ajelec20ajy/Embedded-System-Experiment/ONLY_MAIN/README.md

Zone1~Zone4 Folder : 각 Zone 콘트롤러 및 하위 액추에이터/센서

main.c : 중앙 제어기 코드(라즈베리파이 제로 2W : RaspberryPi OS-64bit, SocketCAN 사용)
