ajelec20ajy/Embedded-System-Experiment/ALL_FILE/Zone1/Zone1_LOCAL/Zone1_LOCAL.ioc

Mcu.UserName=STM32F103C8Tx
PA10.Signal=USART1_RX
PA11.Signal=CAN_RX
PA12.Signal=CAN_TX
PA3.GPIO_Label=DRDY_SONIC
PA3.Signal=GPXTI3
PA4.GPIO_Label=CS_SONIC
PA4.Signal=GPIO_Output
PA5.Signal=SPI1_SCK
PA6.Signal=SPI1_MISO
PA7.Signal=SPI1_MOSI
PA8.GPIO_Label=DRDY_PEDAL
PA8.Signal=GPXTI8
PA9.Signal=USART1_TX
PB12.GPIO_Label=CS_PEDAL
PB12.Signal=GPIO_Output
PB13.Signal=SPI2_SCK
PB14.Signal=SPI2_MISO
PB15.Signal=SPI2_MOSI
PC13-TAMPER-RTC.GPIO_Label=LED
PC13-TAMPER-RTC.Signal=GPIO_Output
