ajelec20ajy/Embedded-System-Experiment/ALL_FILE/Zone1/Zone1_LOCAL/Core/Src/main.c

#include "main.h"
#include "cmsis_os.h"

#include "stdbool.h"
#include <stdio.h>
#include <string.h>
CAN_HandleTypeDef hcan;

SPI_HandleTypeDef hspi1;
SPI_HandleTypeDef hspi2;
DMA_HandleTypeDef hdma_spi1_rx;
DMA_HandleTypeDef hdma_spi1_tx;
DMA_HandleTypeDef hdma_spi2_rx;
DMA_HandleTypeDef hdma_spi2_tx;

UART_HandleTypeDef huart1;

/* Definitions for CAN */
osThreadId_t CANHandle;
const osThreadAttr_t CAN_attributes = {
  .name = "CAN",
  .stack_size = 256 * 4,
  .priority = (osPriority_t) osPriorityHigh,
};
/* Definitions for SPI1 */
osThreadId_t SPI1Handle;
const osThreadAttr_t SPI1_attributes = {
  .name = "SPI1",
  .stack_size = 128 * 4,
  .priority = (osPriority_t) osPriorityHigh,
};
/* Definitions for SPI2 */
osThreadId_t SPI2Handle;
const osThreadAttr_t SPI2_attributes = {
  .name = "SPI2",
  .stack_size = 128 * 4,
  .priority = (osPriority_t) osPriorityHigh,
};
/* Definitions for cansonicQueue */
osMessageQueueId_t cansonicQueueHandle;
const osMessageQueueAttr_t cansonicQueue_attributes = {
  .name = "cansonicQueue"
};
/* Definitions for canpedalQueue */
osMessageQueueId_t canpedalQueueHandle;
const osMessageQueueAttr_t canpedalQueue_attributes = {
  .name = "canpedalQueue"
};

void SystemClock_Config(void);
static void MX_GPIO_Init(void);
static void MX_DMA_Init(void);
static void MX_SPI1_Init(void);
static void MX_SPI2_Init(void);
static void MX_USART1_UART_Init(void);
static void MX_CAN_Init(void);
void canTask(void *argument);
void spi1Task(void *argument);
void spi2Task(void *argument);

#include <stdint.h>
#include <string.h>
#include <stdio.h>
#include "stdlib.h" // atoi
#include "string.h" // memcpy

#define FLAG_SONIC_READ            0x0001
#define FLAG_PEDAL_READ            0x0002
#define FLAG_SONIC_DMA_COMPLETE    0x0004
#define FLAG_PEDAL_DMA_COMPLETE    0x0008


#pragma pack(push,1)
typedef struct{
	uint8_t header;
	int16_t data;
	uint8_t status;
	uint8_t seq;
	uint8_t reserved;
	uint8_t crc;
	uint8_t tail;
}SPI_Packet_t;
#pragma pack(pop)

typedef union{
	SPI_Packet_t pkt;
	uint8_t bytes[8];
}SPI_Buffer_t;

int16_t g_distance;
int16_t g_accel, g_brake, g_pedal;

// SPI용 버퍼. VOLATILE! 매번 체크
volatile SPI_Buffer_t pedal_rx;
volatile SPI_Buffer_t pedal_tx;
volatile SPI_Buffer_t sonic_rx;
volatile SPI_Buffer_t sonic_tx;

volatile uint8_t SPI1_ERR_FLAG = 0; //SPI1의 에러를 알려줄 플래그
volatile uint8_t SPI2_ERR_FLAG = 0; //SPI2의 에러를 알려줄 플래그


static uint8_t crc_xor(const uint8_t *p, int n) { // CRC 계산해주는 함수
  uint8_t c = 0;
  for (int i = 0; i < n; i++) c ^= p[i];
  return c;
}

void HAL_SPI_TxRxCpltCallback(SPI_HandleTypeDef *hspi) {
	if (hspi->Instance == SPI1) {
		osThreadFlagsSet(SPI1Handle, FLAG_SONIC_DMA_COMPLETE);
	}
	else if (hspi->Instance == SPI2) {
		osThreadFlagsSet(SPI2Handle, FLAG_PEDAL_DMA_COMPLETE);
	}
}

void HAL_SPI_ErrorCallback(SPI_HandleTypeDef *hspi) {
	if (hspi->Instance == SPI1) {
		osThreadFlagsSet(SPI1Handle, FLAG_SONIC_DMA_COMPLETE);
		HAL_SPI_DMAStop(hspi); // 그냥 껏다 키기
		hspi->State = HAL_SPI_STATE_READY; // 강제로 통신 가능 상태로 복구
	}
	else if (hspi->Instance == SPI2) {
		osThreadFlagsSet(SPI2Handle, FLAG_PEDAL_DMA_COMPLETE);
		HAL_GPIO_TogglePin(LED_GPIO_Port, LED_Pin);
		HAL_SPI_DMAStop(hspi);
		hspi->State = HAL_SPI_STATE_READY; // 강제로 통신 가능 상태로 복구
	}
}

void HAL_GPIO_EXTI_Callback(uint16_t GPIO_Pin) {
	switch(GPIO_Pin){
	case DRDY_SONIC_Pin:
		osThreadFlagsSet(SPI1Handle, FLAG_SONIC_READ);
		break;
	case DRDY_PEDAL_Pin:

		osThreadFlagsSet(SPI2Handle, FLAG_PEDAL_READ);
		break;
	default:
		break;
	}
}
// CAN
#define OFF 0x01
#define READY 0x02
#define DRIVE 0x04
#define EMERGENCY 0x08
#define MOTOR_ERR 0x10
#define PEDAL_ERR 0x20
#define CENTRAL_DOWN 0x40
#define BROKEN_SELF 0x80

#define ID_1_SONIC 0x010
#define ID_1_PEDAL 0x040
#define ID_1_HB 0x071
#define ID_1_PEDAL_SPI_ERR 0x022

#define ID_2_SONIC 0x011
#define ID_2_MOTOR_STATUS 0x110
#define ID_2_MOTOR_SPI_ERR 0x020
#define ID_2_HB 0x072

#define ID_3_ACC 0x012
#define ID_3_HB 0x073

#define ID_4_IR 0x142
#define ID_4_BTN 0x144
#define ID_4_HB 0x074

#define ID_CENTRAL_MOTOR_ERR 0x001
#define ID_CENTRAL_EMERGENCY 0x002
#define ID_CENTRAL_STATUS 0x004 // = HEARBEAT ID OF CENTRAL
#define ID_HARDWARE_ERR 0x7FF


// RTOS용 FLAG
#define FLAG_STATE_OFF			0x11
#define FLAG_STATE_READY		0x22
#define FLAG_STATE_DRIVE		0x44
#define FLAG_STATE_EMERGENCY	0x88
#define FLAG_STATE_MOTOR_ERR	0xAA

typedef enum { // 에러 종류
    ERR_TYPE_RX_STUCK,    // 데이터 갱신 안됨
    ERR_TYPE_TX_FAIL,     // 내 CAN의 하드웨어 에러
    ERR_TYPE_HW,          // 내 CAN의 하드웨어 에러
    ERR_TYPE_CHKSUM       // 데이터 변조 감지
} CAN_Err_Type;

typedef union {
    struct {
        uint16_t data;
	uint8_t reserved[4];
	uint8_t counter;
	uint8_t checksum;
    } __attribute__((packed)) data16;
    struct {
        uint16_t data1;
        uint16_t data2;
        uint8_t reserved[2];
	uint8_t counter;
	uint8_t checksum;
    } __attribute__((packed)) data32;
    uint8_t bytes[8];
} CAN_Payload_t; // CAN 데이터 패킷

typedef struct{
	uint8_t z1;
	uint8_t z2;
	uint8_t z3;
	uint8_t z4;
	uint8_t central;
} CAN_CNT; // 다용도 카운터 구조체

CAN_CNT stuck_counter; // 중앙제어기 RX 걸렸는지
CAN_CNT last_counter; // 패킷의 시퀀스 검증용
CAN_CNT can_rx_err_cnt; // 에러 카운트용
uint32_t last_zone_rx_time; // 중앙 제어기 다운 타임아웃 감지용
volatile uint8_t state_global = OFF; // 시스템 상태
uint8_t global_tx_counter = 0; // 패킷에 담을 시퀀스를 위함

void Put_Latest_Data(osMessageQueueId_t queueHandle, int16_t data){ // Size 1 Queue Overwrite하기
	int16_t msg = data;
	    if(osMessageQueueGetCount(queueHandle) > 0){
	        int16_t dummy;
	        osMessageQueueGet(queueHandle, &dummy, NULL, 0);
	    }
	    osMessageQueuePut(queueHandle, &msg, 0, 0);
}
void CAN_OFF_FILTER(){ // 필터 끄기
	CAN_FilterTypeDef canFilter;
				canFilter.FilterBank = 0;
				canFilter.FilterMode = CAN_FILTERMODE_IDLIST;
				canFilter.FilterScale = CAN_FILTERSCALE_16BIT;
				canFilter.FilterIdHigh = (0x001 << 5);
				canFilter.FilterIdLow = (0x002 << 5);
				canFilter.FilterMaskIdHigh = (0x004 << 5);
				canFilter.FilterMaskIdLow = (0x000 << 5);
				canFilter.FilterFIFOAssignment = CAN_RX_FIFO0;
				canFilter.FilterActivation = DISABLE;
				canFilter.SlaveStartFilterBank = 14;
				HAL_CAN_ConfigFilter(&hcan, &canFilter);
}
void CAN_ERR_HANDLE(uint32_t ID, CAN_Err_Type type){ // CAN 에러 핸들러
	switch(ID){
	case ID_1_SONIC:
	case ID_1_PEDAL:
	case ID_1_HB:
		can_rx_err_cnt.z1++;
		if(can_rx_err_cnt.z1>=20){
			HAL_CAN_Stop(&hcan);
			state_global = BROKEN_SELF;
		}
		break;
	case ID_CENTRAL_STATUS:
		can_rx_err_cnt.central++;
		if(can_rx_err_cnt.central>=20){
			CAN_OFF_FILTER();
			state_global = CENTRAL_DOWN;
		}
		break;

	case ID_HARDWARE_ERR: // 하드웨어 에러는 바로 처리
		if(type == ERR_TYPE_HW){
			state_global = BROKEN_SELF;
		}
		break;

	default:
		break;
	}
}

void HAL_CAN_RxFifo0MsgPendingCallback(CAN_HandleTypeDef *hcan){ // 캔 RX 콜백
	CAN_RxHeaderTypeDef rxHeader;
	CAN_Payload_t payload = { 0 };
    if(HAL_CAN_GetRxMessage(hcan, CAN_RX_FIFO0, &rxHeader, payload.bytes) == HAL_OK){
    	if(rxHeader.IDE == CAN_ID_STD){
    			uint8_t received_sum = 0;
    			for (int i = 0; i < 7; i++) { // Checksum
    				received_sum += payload.bytes[i];
    			}
    			if (received_sum != payload.bytes[7]) {
    				CAN_ERR_HANDLE(rxHeader.StdId, ERR_TYPE_CHKSUM);
    				return; // 이번거 데이터 오염되었다 판단, 그냥 건너뜀
    			}
    			switch (rxHeader.StdId) {
    			case ID_CENTRAL_MOTOR_ERR:
    				if (payload.data16.counter == last_counter.central) {
    					if (++stuck_counter.central > 5) {
    						CAN_ERR_HANDLE(rxHeader.StdId, ERR_TYPE_RX_STUCK);
    						return; // 처리 후 return
    					}
    				}
    				else {
    					stuck_counter.central = 0;
    					last_counter.central = payload.data16.counter;
    				}

    				state_global = MOTOR_ERR;
    				last_zone_rx_time = HAL_GetTick(); // 중앙제어기 HeartBeat 감지용
    				break;
    			case ID_CENTRAL_EMERGENCY:
    				if (payload.data16.counter == last_counter.central) {
    					if (++stuck_counter.central > 5) {
    						CAN_ERR_HANDLE(rxHeader.StdId, ERR_TYPE_RX_STUCK);
    						return; // 처리 후 return
    					}
    				}
    				else {
    					stuck_counter.central = 0;
    					last_counter.central = payload.data16.counter;
    				}

    				state_global = EMERGENCY;
    				last_zone_rx_time = HAL_GetTick(); // 중앙제어기 HeartBeat 감지용
    				break;
    			case ID_CENTRAL_STATUS:
    				if (payload.data16.counter == last_counter.central) {
    					if (++stuck_counter.central > 5) {
    						CAN_ERR_HANDLE(rxHeader.StdId, ERR_TYPE_RX_STUCK);
    						return; // 처리 후 return
    					}
    				}
    				else {
    					stuck_counter.central = 0;
    					last_counter.central = payload.data16.counter;
    				}

    				if (rxHeader.DLC == 8) {
    					state_global = payload.data16.data;
    				}
    				can_rx_err_cnt.central = 0;
    				last_zone_rx_time = HAL_GetTick(); // 중앙제어기 HeartBeat 감지용
    				break;
    			}
    	}
    }
}

void CAN_INIT() { // CAN 초기화
	// 필터처리
	CAN_FilterTypeDef canFilter;
	canFilter.FilterBank = 0;
	canFilter.FilterMode = CAN_FILTERMODE_IDLIST;
	canFilter.FilterScale = CAN_FILTERSCALE_16BIT;
	canFilter.FilterIdHigh = (0x001 << 5);
	canFilter.FilterIdLow = (0x002 << 5);
	canFilter.FilterMaskIdHigh = (0x004 << 5);
	canFilter.FilterMaskIdLow = (0x000 << 5);
	canFilter.FilterFIFOAssignment = CAN_RX_FIFO0;
	canFilter.FilterActivation = ENABLE;
	canFilter.SlaveStartFilterBank = 14;

	if (HAL_CAN_ConfigFilter(&hcan, &canFilter) != HAL_OK) {
		Error_Handler();
	}

	canFilter.FilterBank = 1;
	canFilter.FilterIdHigh = (0x001 << 5);
	canFilter.FilterIdLow = (0x000 << 5);
	canFilter.FilterMaskIdHigh = (0x000 << 5);
	canFilter.FilterMaskIdLow = (0x000 << 5);

	if (HAL_CAN_ConfigFilter(&hcan, &canFilter) != HAL_OK) {
		Error_Handler();
	}

	//시작
	last_zone_rx_time = HAL_GetTick();
	HAL_CAN_Start(&hcan);
	HAL_CAN_ActivateNotification(&hcan, CAN_IT_RX_FIFO0_MSG_PENDING);
}

void CAN_SEND(uint32_t ID) { // CAN 송신 함수
	    CAN_TxHeaderTypeDef txHeader ={0};
	    uint32_t txMailbox;
	    CAN_Payload_t payload ={0};

	    txHeader.IDE = CAN_ID_STD;
	    txHeader.RTR = CAN_RTR_DATA;
	    txHeader.TransmitGlobalTime = DISABLE;
	    txHeader.StdId = ID;
	    txHeader.DLC = 8;

	    payload.data16.counter = global_tx_counter++; // 카운터(시퀀스 번호) 삽입
	    switch(ID){
		case ID_1_SONIC:
			payload.data16.data = g_distance;

			break;
		case ID_1_PEDAL:
			if(state_global == DRIVE || state_global == CENTRAL_DOWN) payload.data16.data = g_pedal;
			else payload.data16.data = 0; // emergency일때 여기서 걸린다.

			break;
		case ID_1_HB: // heartbeat
			payload.data16.data = state_global;
			//payload.data16.counter = 0; // 의도적으로 (4) EMEGENCY2 일으키기
			break;
		case ID_1_PEDAL_SPI_ERR: // 이 ID가 중앙에게 가면 중앙이 PEDAL_ERR 상태를 다른 Zone에 전파해줌
			payload.data16.data = 0; //
		default:
			break;
	    }


	    uint8_t sum = 0;
	        for (int i = 0; i < 7; i++) {
	        	sum += payload.bytes[i];
	        }
	        payload.data16.checksum = sum;

	    uint32_t tick = HAL_GetTick();
	    while (HAL_CAN_GetTxMailboxesFreeLevel(&hcan) == 0) {
	    	if (HAL_GetTick() - tick > 10) {
	    		CAN_ERR_HANDLE(ID, ERR_TYPE_TX_FAIL); // 메일박스 고임 타임아웃처리
	    		return; // 타임아웃 시 포기
	    	}
	    }

	    if (HAL_CAN_AddTxMessage(&hcan, &txHeader, payload.bytes, &txMailbox) != HAL_OK) {
	    	CAN_ERR_HANDLE(ID, ERR_TYPE_HW); // 창구에서 거절
	    }
}

void HAL_CAN_ErrorCallback(CAN_HandleTypeDef *hcan) {
	      uint32_t err = HAL_CAN_GetError(hcan); // 먼 에러인지 검사
	      uint8_t any = 0;
	      if(err & HAL_CAN_ERROR_BOF){ // BOF
	    	  any = 1;
	    	  CAN_ERR_HANDLE(ID_HARDWARE_ERR, ERR_TYPE_HW);
	      }
	      if(err & HAL_CAN_ERROR_ACK){ // ACK 없을때
	    	  any = 1;
	    	  can_rx_err_cnt.central++; // 중앙이 문제니 ACK가 없을듯
	      }

	      if(err & HAL_CAN_ERROR_RX_FOV0){ // fifo 꽉 찬 경우에
	    	  any = 1;
	    	  CAN_RxHeaderTypeDef rxHeader;
	    	  uint8_t dummyData[8];
	    	  uint32_t fillLevel = HAL_CAN_GetRxFifoFillLevel(hcan, CAN_RX_FIFO0); // 찼는지 검사
	    	  while (fillLevel > 0) {
	    	  HAL_CAN_GetRxMessage(hcan, CAN_RX_FIFO0, &rxHeader, dummyData); // 메시지를 더미로 읽어 fifo 비우기
	    	  fillLevel--;
	    	  }
	      }
	      if(!any){ // 위의 경우들은 아닌경우, 포괄에러처리
	    	  CAN_ERR_HANDLE(ID_HARDWARE_ERR, ERR_TYPE_HW);
	      }
}

int main(void)
{
  HAL_Init();

  SystemClock_Config();

  MX_GPIO_Init();
  MX_DMA_Init();
  MX_SPI1_Init();
  MX_SPI2_Init();
  MX_USART1_UART_Init();
  MX_CAN_Init();

  HAL_GPIO_WritePin(CS_SONIC_GPIO_Port, CS_SONIC_Pin, GPIO_PIN_SET);
  HAL_GPIO_WritePin(CS_PEDAL_GPIO_Port, CS_PEDAL_Pin, GPIO_PIN_SET);
  CAN_INIT();

  osKernelInitialize();

  cansonicQueueHandle = osMessageQueueNew (1, sizeof(uint16_t), &cansonicQueue_attributes);
  canpedalQueueHandle = osMessageQueueNew (1, sizeof(uint16_t), &canpedalQueue_attributes);

  CANHandle = osThreadNew(canTask, NULL, &CAN_attributes);
  SPI1Handle = osThreadNew(spi1Task, NULL, &SPI1_attributes);
  SPI2Handle = osThreadNew(spi2Task, NULL, &SPI2_attributes);

  osKernelStart();

  while (1)
  {
  }
}

void canTask(void *argument)
{
		uint16_t rx_msg;
	  uint32_t tick = osKernelGetTickCount();
	  const uint32_t kPeriod = 10U; // 10ms 주기 (100Hz)
	  uint8_t state_local = OFF;
	  bool can_stop_flag = false;

  for(;;)
  {
	  tick += kPeriod;
	  state_local = state_global;
	  if ((state_local != OFF) && (state_local != CENTRAL_DOWN) && (state_local != BROKEN_SELF))
	        {
	            if (HAL_GetTick() - last_zone_rx_time > 200) {
	          	  state_local = CENTRAL_DOWN;
	            }
	  }
	  if(SPI2_ERR_FLAG){
		  CAN_SEND(ID_1_PEDAL_SPI_ERR);
	  }
	  switch(state_local){
	        case DRIVE:
                if (osMessageQueueGet(canpedalQueueHandle, &rx_msg, NULL, 0) == osOK) {
                	if(!SPI2_ERR_FLAG) CAN_SEND(ID_1_PEDAL);
                }

                // 초음파 데이터 전송 (Queue에 데이터가 있을 때만)
                if (osMessageQueueGet(cansonicQueueHandle, &rx_msg, NULL, 0) == osOK) {
                    CAN_SEND(ID_1_SONIC);
                }
                CAN_SEND(ID_1_HB);
                break;
	        case EMERGENCY:
	        	CAN_SEND(ID_1_PEDAL); // CAN_SEND 내부에서 state == EMERGENCY일때 강제로 0을 보낸다
	        case READY:
	        case MOTOR_ERR: // 모터 정지시에는 하트비트만 보낸다
	        	CAN_SEND(ID_1_HB);
	        	break;
	        case OFF:
	        	break;
	        case CENTRAL_DOWN: // 중앙이 망가졌어도 페달 조작은 해서 사용자가 모터를 멈추는 등 운행 가능하게
	        	CAN_OFF_FILTER();
                if (osMessageQueueGet(canpedalQueueHandle, &rx_msg, NULL, 0) == osOK) {
                	if(!SPI2_ERR_FLAG) CAN_SEND(ID_1_PEDAL);
                }
	        	break;
	        case BROKEN_SELF: // 내 CAN이 망가졌으면 아예 CAN 멈춤
	        	if(can_stop_flag == false)
	        	HAL_CAN_Stop(&hcan);
	        	can_stop_flag = true;
	        	break;
	        case PEDAL_ERR: // 페달 에러시에는 하트비트와 초음파값만
                if (osMessageQueueGet(cansonicQueueHandle, &rx_msg, NULL, 0) == osOK) {
                    CAN_SEND(ID_1_SONIC);
                }
                CAN_SEND(ID_1_HB);
                break;
	  }
	  osDelayUntil(tick); // 100Hz
  }
}

void spi1Task(void *argument)
{
	/* USER CODE BEGIN 5 */
	  uint8_t SPI1_ERR_CNT = 0;
	  uint8_t last_rx_seq = 0xFF;
	  uint8_t seq = 0; // [수정 1] 시퀀스 변수 추가

	  for(;;)
	  {
	    // [1] DRDY 신호 대기 (초음파 센서가 "나 데이터 준비됐어" 할 때까지)
	    uint32_t result = osThreadFlagsWait(FLAG_SONIC_READ, osFlagsWaitAny, 150);

	    // [2] 초음파 값 받기
	    if (result & FLAG_SONIC_READ) {
	     	memset(&sonic_tx, 0, sizeof(sonic_tx));
	    	bool frame_valid = true;

	    	HAL_GPIO_WritePin(CS_SONIC_GPIO_Port, CS_SONIC_Pin, GPIO_PIN_RESET); // 슬레이브에게 통신 시작 알림
	    	if(HAL_SPI_TransmitReceive_DMA(&hspi1, (uint8_t*)&sonic_tx, (uint8_t*)&sonic_rx, 8) == HAL_OK){ // 요청
	    		// 타임아웃 20ms
	    		uint32_t sonic_res = osThreadFlagsWait(FLAG_SONIC_DMA_COMPLETE, osFlagsWaitAny, 20); // SPI DMA 완료 콜백에서 플래그 보내주길 기다리며 블락

	    		if(sonic_res == osFlagsErrorTimeout){ // DMA 타임아웃
	    			HAL_SPI_DMAStop(&hspi1); // 멈춤, 복구시도
	    			hspi1.State = HAL_SPI_STATE_READY; // READY로 강제 변경해서 복구시도(위험한 방법이라고 배움)
	    			frame_valid = false;
	    		}
	    	}
	    	else{
	    		frame_valid = false;
	    	}
	    	HAL_GPIO_WritePin(CS_SONIC_GPIO_Port, CS_SONIC_Pin, GPIO_PIN_SET); //통신 완료 처리

	    	// 데이터 검증 - 헤더, 테일, CRC
	    	if(frame_valid){
	        	if(sonic_rx.pkt.header != 0xAA) frame_valid = false;
	        	if(sonic_rx.pkt.tail != 0xED) frame_valid = false;
	        	if(crc_xor((uint8_t *)&sonic_rx.pkt, 6) != sonic_rx.pkt.crc) frame_valid = false;
	    	}

	        bool skip_update = false;

	    	if(!frame_valid){
	    		if(++SPI1_ERR_CNT >= 5){

	    			SPI1_ERR_FLAG = 1;
	    		}
	    		skip_update = true; // 이번 턴은 업데이트 건너뜀
	    	}
	        else if (sonic_rx.pkt.seq == last_rx_seq) {
	    	    if (++SPI1_ERR_CNT >= 5)
	    	        SPI1_ERR_FLAG = 1;
	    	    skip_update = true; // 중복 데이터니 업데이트 건너뜀
	    	}
	        else {
	            // 정상 데이터 수신
	        	last_rx_seq = sonic_rx.pkt.seq;
	        	SPI1_ERR_CNT = 0;
	        	SPI1_ERR_FLAG = 0;
	            skip_update = false;
	        }

	        // 유효할 때만 값 업데이트 및 큐 전송
	        if(!skip_update) {
	        	g_distance = sonic_rx.pkt.data; // 값 업데이트
	        	Put_Latest_Data(cansonicQueueHandle, g_distance); // 큐로 보냄
	        }
	    }
	  }

}


void spi2Task(void *argument)
{
	  uint8_t last_rx_seq = 0xFF;
	  uint8_t SPI2_ERR_CNT = 0;

	  for(;;)
	  {
	      // 페달 DRDY 인터럽트 대기
	      uint32_t result = osThreadFlagsWait(FLAG_PEDAL_READ, osFlagsWaitAny, osWaitForever);

	      if (result & FLAG_PEDAL_READ) {
	    	  memset(&pedal_tx, 0, sizeof(pedal_tx));
	          bool frame_valid = true;

	          // SPI 통신 수행
	          HAL_GPIO_WritePin(CS_PEDAL_GPIO_Port, CS_PEDAL_Pin, GPIO_PIN_RESET); // 슬레이브에게 통신 시작 알림
	          if(HAL_SPI_TransmitReceive_DMA(&hspi2, (uint8_t*)&pedal_tx, (uint8_t*)&pedal_rx, 8) == HAL_OK){
	              uint32_t pedal_res = osThreadFlagsWait(FLAG_PEDAL_DMA_COMPLETE, osFlagsWaitAny, 20);
	              if(pedal_res == osFlagsErrorTimeout){
	                  HAL_SPI_DMAStop(&hspi2);
	                  hspi2.State = HAL_SPI_STATE_READY;
	                  frame_valid = false;
	              }
	          }
	          else { frame_valid = false; }

	          HAL_GPIO_WritePin(CS_PEDAL_GPIO_Port, CS_PEDAL_Pin, GPIO_PIN_SET); //통신 완료 처리

	          // 데이터 검증- 헤더, 테일, CRC
	          if(frame_valid){
	              if(pedal_rx.pkt.header != 0xAA) frame_valid = false;
	              if(pedal_rx.pkt.tail != 0xED) frame_valid = false;
	              if(crc_xor((uint8_t *)&pedal_rx.pkt, 6) != pedal_rx.pkt.crc) frame_valid = false;
	          }

	          bool skip_update = false;

	          if(!frame_valid){ // 패킷 깨짐
	              if(++SPI2_ERR_CNT >= 30){
	                  if(state_global == DRIVE) SPI2_ERR_FLAG = 1;
	              }
	              skip_update = true; // 깨진건 어쩔 수 없이 버림
	          }
	          else if (pedal_rx.pkt.seq == last_rx_seq) { // 시퀀스 중복 즉 패킷에러
	              // 경고는 하되, 데이터는 갱신하 (슬레이브가 시퀀스 증가 안시키는 놈일 수 있음)
	              if (++SPI2_ERR_CNT >= 30){
	                  if(state_global == DRIVE) SPI2_ERR_FLAG = 1;
	              }
	          }
	          else { // 정상 수신
	              last_rx_seq = pedal_rx.pkt.seq; // 다음 루프 시퀀스 비교를 위해
	              SPI2_ERR_CNT = 0; //에러 카운터 초기화
	              SPI2_ERR_FLAG = 0;
	              skip_update = false;
	          }

	          // 유효한 경우에만 데이터 반영하고 큐 전송
	          if(!skip_update) {
	              g_pedal = pedal_rx.pkt.data;
	              // 상태 체크 로직
	              g_pedal = ((state_global == DRIVE) || (state_global == CENTRAL_DOWN)) ? g_pedal : 0;
	              Put_Latest_Data(canpedalQueueHandle, g_pedal);
	          }
	      }
	      osDelay(1);
	  }
}
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
