ajelec20ajy/Embedded-System-Experiment/ALL_FILE/Zone1/Zone1_LOCAL/Core/Inc/main.h

#define LED_Pin GPIO_PIN_13
#define LED_GPIO_Port GPIOC
#define DRDY_SONIC_Pin GPIO_PIN_3
#define DRDY_SONIC_GPIO_Port GPIOA
#define DRDY_SONIC_EXTI_IRQn EXTI3_IRQn
#define CS_SONIC_Pin GPIO_PIN_4
#define CS_SONIC_GPIO_Port GPIOA
#define CS_PEDAL_Pin GPIO_PIN_12
#define CS_PEDAL_GPIO_Port GPIOB
#define DRDY_PEDAL_Pin GPIO_PIN_8
#define DRDY_PEDAL_GPIO_Port GPIOA
#define DRDY_PEDAL_EXTI_IRQn EXTI9_5_IRQn
