ajelec20ajy/Embedded-System-Experiment/(commit log)

2026-01-13 Create 설명
2026-02-11 RaspberryPi Zero 2W Code
    Central Controller
