ajelec20ajy/Embedded-System-Experiment/(notices)

Notices in the files:
ALL_FILE/Zone1/Zone1_LOCAL/Core/Inc/main.h:
Copyright (c) 2025 STMicroelectronics.
All rights reserved.
This software is licensed under terms that can be found in the LICENSE file
